xmirakulix/IoTaWatt/Hardware/greg_xmix/PCB.png

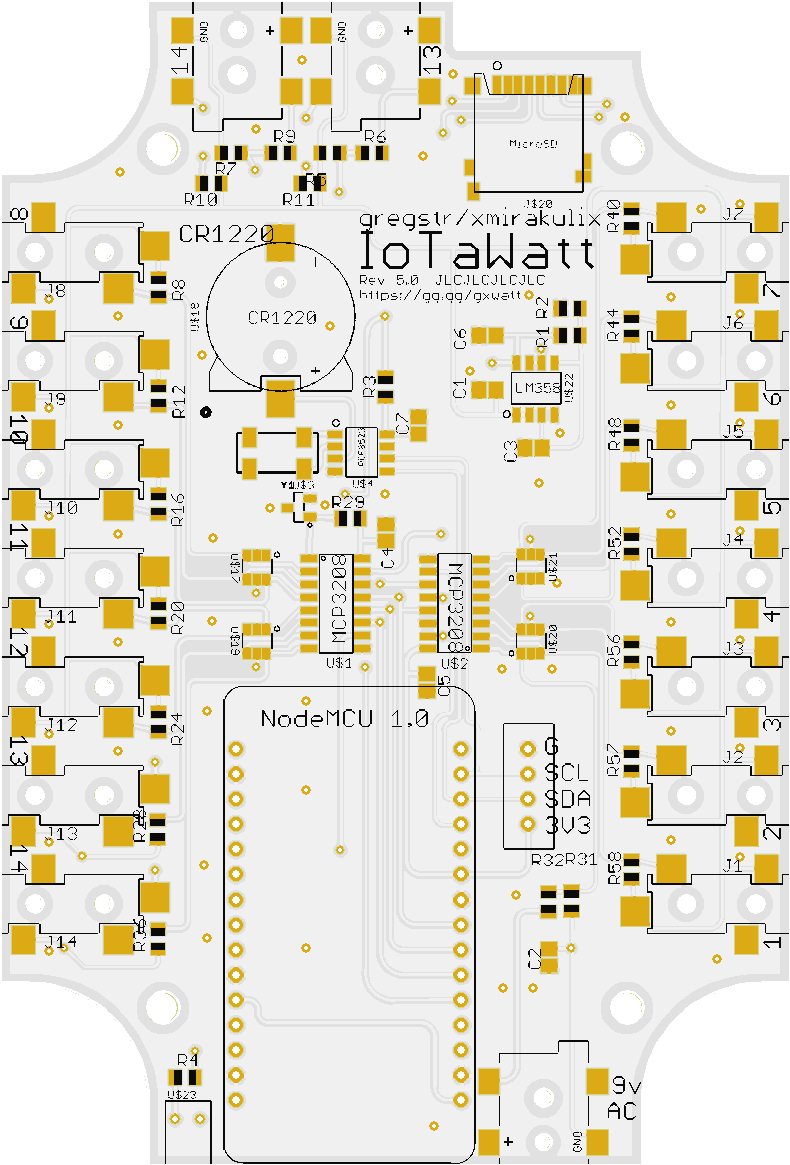
Hardware/greg_xmix/PCB.png
