xmirakulix/IoTaWatt/Hardware/greg_xmix/Parts List.xlsx

Part | Name | Footprint | Anzahl | LCSC Part | LCSC Preis | DigiKey Part | DigiKey Preis | Link | Amazon Preis
.1uF | C3 C4 C5 C6 | C0805 | 4 | C49678 | $0.0043
10uF | C1 C2 C7 | C0805 | 3 | C15850 | $0.0132
None | R10 R11 | R0805 | 2 | C17477 | $0.0022
20 | R8 R12 R16 R20 R24 R28 R36 R40 R44 R48 R52 R56 R57 R58 | R0805 | 14 | C723660 | $0.0470
220 | R4 | R0805 | 1 | C17557 | $0.0018
1K | R3 R5 R7 R29 R31 | R0805 | 5 | C309081 | $0.0286
4.7K | R1 R2 | R0805 | 2 | C515732 | $0.0319
12K | R6 R9 R32 | R0805 | 3 | C515719 | $0.0367
32Khz | Y1 | CRYSTAL_8X3.8 | 1 | C179637 | $1.5436
LM358_DUAL_OP-AMP | U$22 | SOIC_8 | 1 | C5423 | $0.1311
MCP3208 | U$1 U$2 | SOIC_16 | 2 | C16939 | $4.6200
PCF8523_RTC | U$4 | SOIC_8 | 1 | C2651516 | $1.6402
TVS_4CHAN_ARRAYSC-74 | U$17 U$19 U$20 U$21 | SC-74 | 4 | C531179 | $0.2134
STEREO_SMD | J1 J2 J3 J4 J5 J6 J7 J8 J9 J10 J11 J12 J13 J14 | STEREO_SMT | 14 |  |  | CP-3524SJCT-ND | €0.7704
MICROSD_PUSH/PULL | J$20 | MICROSD | 1 |  |  | 114-00841-68-1-ND | €1.3900
2.1MMJACKSMT | J0 J15 J16 | DCJACK_2MM_SMT | 3 |  |  | CP-002AHPJCT-ND | €1.3800
VREF_SHUNT | U$3 | SOT23_3 | 1 |  |  | LM4040BIM3-2.5CT-ND | €1.8600
CR1220SMD | U$18 | CR1220SMD | 1 |  |  | BC501SM-ND | €1.0500
HEADER_1X4 | U$5 | HEADER_1X4 | 1 |  |  | 2057-PH1-04-UA-ND | €0.0900
LED_RT_TRH | U$23 | LED_TH_RT | 1 |  |  | 67-2237-ND | €0.9500
NODEMCU | U$16 | NODEMCU | 1 |  |  |  |  | https://www.amazon.de/dp/B0754LZ73Z | €4.3000
SD Card |  |  | 1 |  |  |  |  | https://www.amazon.de/Verbatim-44082-Klasse-Micro-Adapter/dp/B00CBAUIEU/ | €5.5300
 |  |  |  | Summe | $14.45 |  | €20.2656 |  | €9.8300
 |  |  |  | x5 | $111.00 |  | €101.3280 |  | €49.1500
 |  |  |  |  | 55 EUR pro Stk
