xmirakulix/IoTaWatt/Hardware/greg_xmix/Eagle/IotaWatt5.0.brd

## EAGLE design Hardware/greg_xmix/Eagle/IotaWatt5.0.brd (2023-01-08)

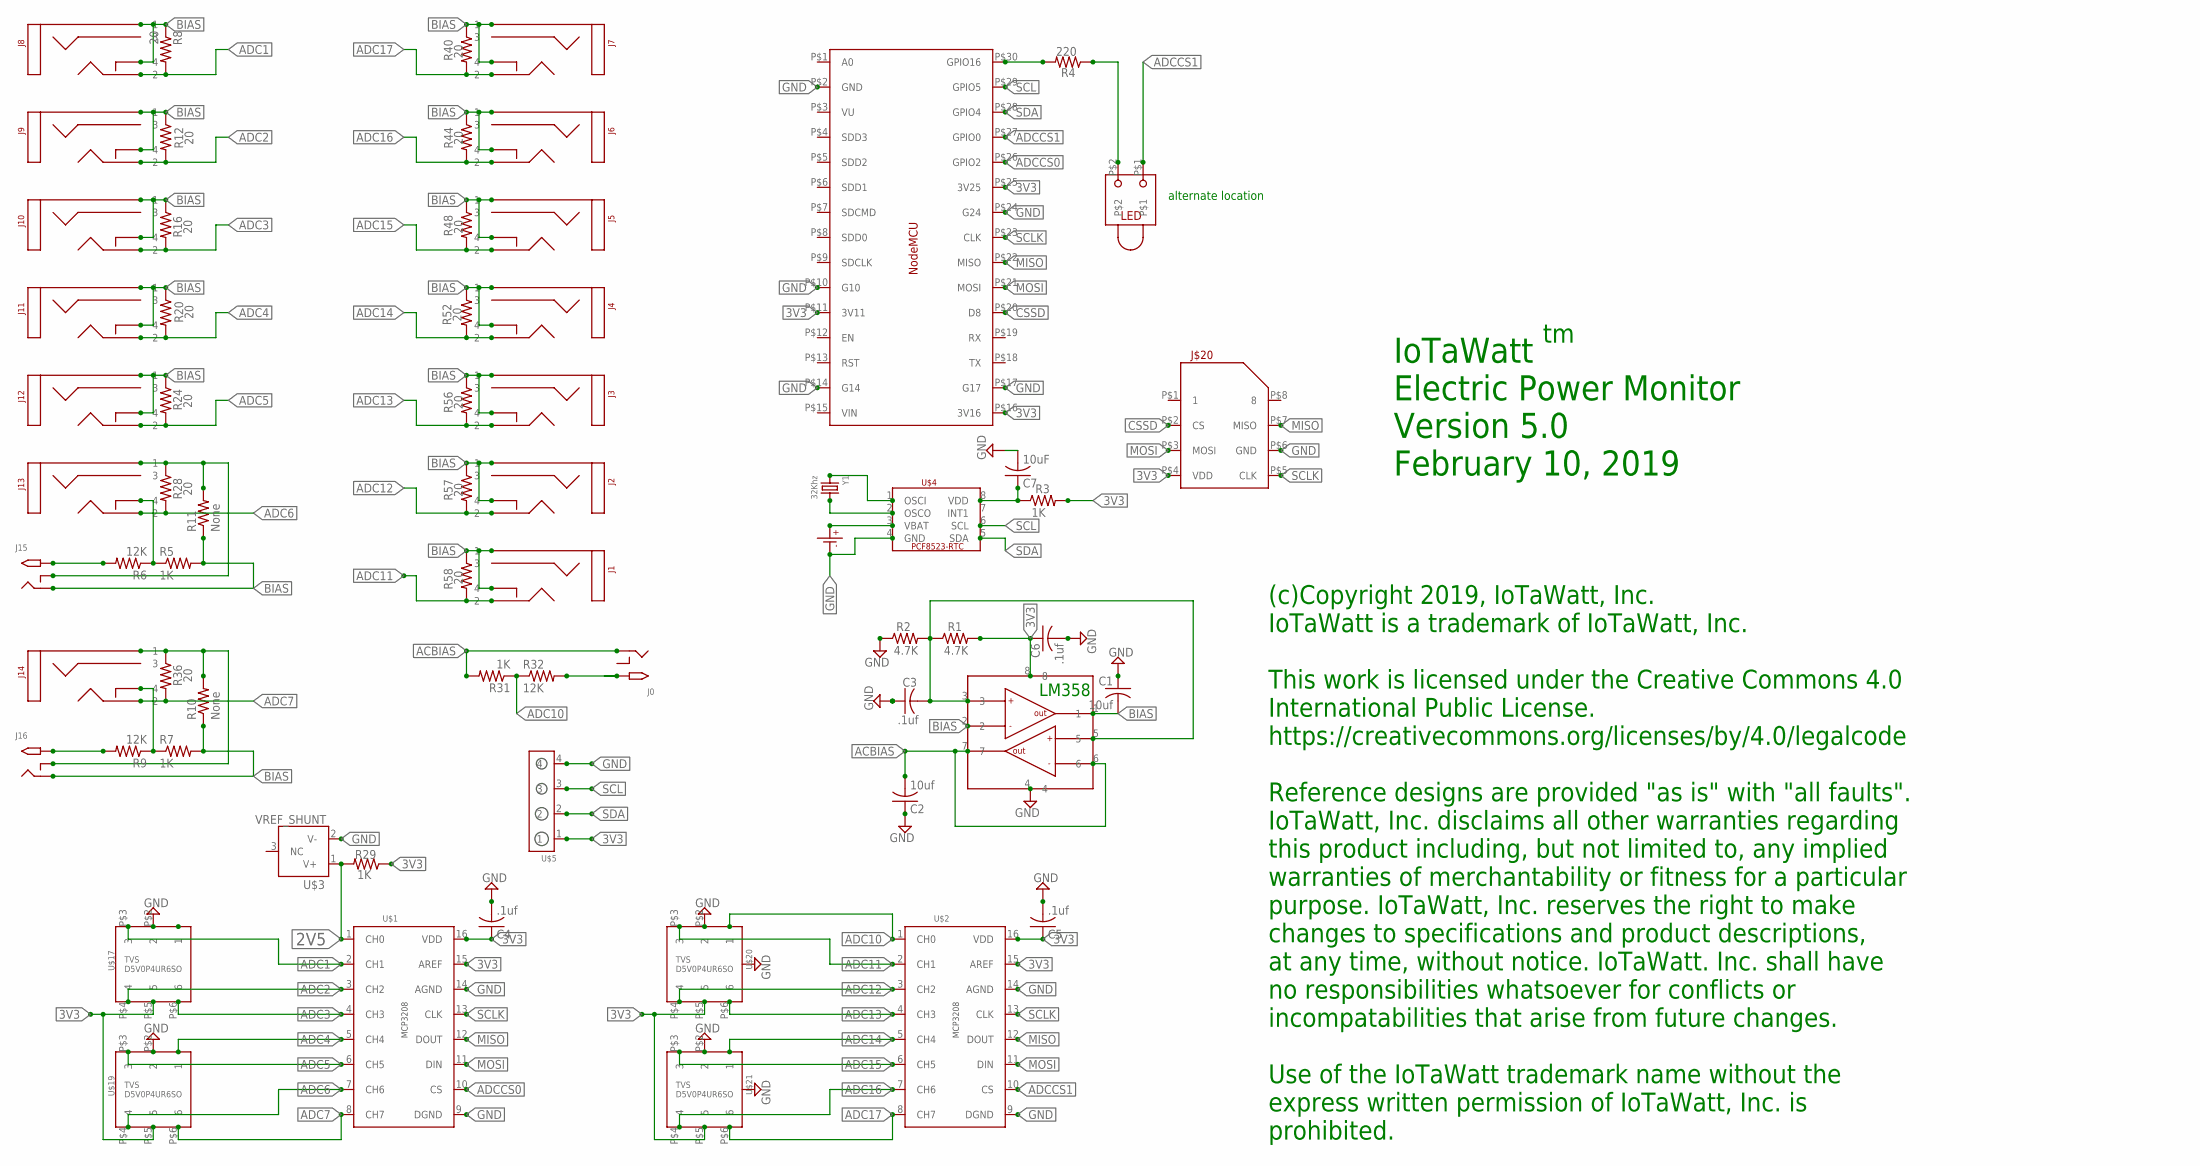
[picture p2: schematic IotaWatt5.0.sch]

Parts:
C1, C2: 10uf; C0805; LCSC_PART C15850
C3, C4, C5, C6: .1uf; C0805; LCSC_PART C49678
C7: 10uF; C0805; LCSC_PART C15850
J0, J15, J16: 2.1MMJACKSMT; DCJACK_2MM_SMT
J1, J2, J3, J4, J5, J6, J7, J8, J9, J10, J11, J12, J13, J14: STEREO_SMD; STEREO_SMT
J$20: MICROSD_PUSH/PULL; MICROSD
R1, R2: 4.7K; R0805; LCSC_PART C515732
R3, R5, R7, R29, R31: 1K; R0805; LCSC_PART C309081
R4: 220; R0805; LCSC_PART C17557
R6, R9, R32: 12K; R0805; LCSC_PART C515719
R8, R12, R16, R20, R24, R28, R36, R40, R44, R48, R52, R56, R57, R58: 20; R0805; LCSC_PART C723660
R10, R11: None; R0805; LCSC_PART C17477
U$1, U$2: MCP3208; SOIC_16; LCSC_PART C16939
U$3: VREF_SHUNT; SOT23_3
U$4: PCF8523_RTC; SOIC_8; LCSC_PART C2651516
U$5: HEADER_1X4
U$16: NODEMCU
U$17, U$19, U$20, U$21: TVS_4CHAN_ARRAYSC-74; SC-74; LCSC_PART C531179
U$18: CR1220SMD
U$22: LM358_DUAL_OP-AMP; SOIC_8; LCSC_PART C5423
U$23: LED_RT_TRH; LED_TH_RT
Y1: 32Khz; CRYSTAL_8X3.8; LCSC_PART C179637

Connections:
2V5: R29.2, U$1.1 (CH0), U$3.1 (V+)
3V3: C4.1, C5.1, C6.1, J$20.P$4 (VDD), R1.2, R3.2, R29.1, U$1.15 (AREF), U$1.16 (VDD), U$2.15 (AREF), U$2.16 (VDD), U$5.1, U$16.P$11 (3V11), U$16.P$16 (3V16), U$16.P$25 (3V25), U$17.P$5 (5), U$19.P$5 (5), U$20.P$5 (5), U$21.P$5 (5), U$22.8
ACBIAS: C2.2, J0.GND (RING), R31.2, U$22.6, U$22.7
ADC1: J8.P$2 (2), R8.2, U$1.2 (CH1), U$17.P$3 (3)
ADC2: J9.P$2 (2), R12.2, U$1.3 (CH2), U$17.P$4 (4)
ADC3: J10.P$2 (2), R16.2, U$1.4 (CH3), U$17.P$6 (6)
ADC4: J11.P$2 (2), R20.2, U$1.5 (CH4), U$19.P$1 (1)
ADC5: J12.P$2 (2), R24.2, U$1.6 (CH5), U$19.P$3 (3)
ADC6: J13.P$2 (2), R28.2, U$1.7 (CH6), U$19.P$4 (4)
ADC7: J14.P$2 (2), R36.2, U$1.8 (CH7), U$19.P$6 (6)
ADC10: R31.1, R32.1, U$2.1 (CH0), U$20.P$1 (1)
ADC11: J1.P$2 (2), R58.2, U$2.2 (CH1), U$20.P$3 (3)
ADC12: J2.P$2 (2), R57.2, U$2.3 (CH2), U$20.P$4 (4)
ADC13: J3.P$2 (2), R56.2, U$2.4 (CH3), U$20.P$6 (6)
ADC14: J4.P$2 (2), R52.2, U$2.5 (CH4), U$21.P$1 (1)
ADC15: J5.P$2 (2), R48.2, U$2.6 (CH5), U$21.P$3 (3)
ADC16: J6.P$2 (2), R44.2, U$2.7 (CH6), U$21.P$4 (4)
ADC17: J7.P$2 (2), R40.2, U$2.8 (CH7), U$21.P$6 (6)
ADCCS0: U$1.10 (CS), U$16.P$26 (GPIO2)
ADCCS1: U$2.10 (CS), U$16.P$27 (GPIO0), U$23.P$1
BIAS: C1.2, J1.P$1 (1), J1.P$4 (4), J2.P$1 (1), J2.P$4 (4), J3.P$1 (1), J3.P$4 (4), J4.P$1 (1), J4.P$4 (4), J5.P$1 (1), J5.P$4 (4), J6.P$1 (1), J6.P$4 (4), J7.P$1 (1), J7.P$4 (4), J8.P$1 (1), J8.P$4 (4), J9.P$1 (1), J9.P$4 (4), J10.P$1 (1), J10.P$4 (4), J11.P$1 (1), J11.P$4 (4), J12.P$1 (1), J12.P$4 (4), J15.GND (RING), J16.GND (RING), R5.2, R7.2, R8.1, R10.1, R11.1, R12.1, R16.1, R20.1, R24.1, R40.1, R44.1, R48.1, R52.1, R56.1, R57.1, R58.1, U$22.1, U$22.2
CSSD: J$20.P$2 (CS), U$16.P$20 (D8)
GND: C1.1, C2.1, C3.1, C4.2, C5.2, C6.2, C7.2, J$20.P$6 (GND), R2.1, U$1.9 (DGND), U$1.14 (AGND), U$2.9 (DGND), U$2.14 (AGND), U$3.2 (V-), U$4.4 (GND), U$5.4, U$16.P$2 (GND), U$16.P$10 (G10), U$16.P$14 (G14), U$16.P$17 (G17), U$16.P$24 (G24), U$17.P$2 (2), U$18.P- (P$-), U$19.P$2 (2), U$20.P$2 (2), U$21.P$2 (2), U$22.4
MISO: J$20.P$7 (MISO), U$1.12 (DOUT), U$2.12 (DOUT), U$16.P$22 (MISO)
MOSI: J$20.P$3 (MOSI), U$1.11 (DIN), U$2.11 (DIN), U$16.P$21 (MOSI)
unnamed: C7.1, R3.1, U$4.8 (VDD)
unnamed: J15.PWR2 (TIP), R6.2
unnamed: J16.PWR2 (TIP), R9.2
unnamed: J14.P$1 (1), J16.GNDBREAK (RING_SW), R10.2, R36.1
unnamed: J13.P$1 (1), J15.GNDBREAK (RING_SW), R11.2, R28.1
unnamed: J14.P$4 (4), R7.1, R9.1
unnamed: R4.1, U$23.P$2
unnamed: J13.P$4 (4), R5.1, R6.1
unnamed: R4.2, U$16.P$30 (GPIO16)
unnamed: J0.PWR2 (TIP), R32.2
unnamed: U$4.3 (VBAT), U$18.P+ (P$+)
unnamed: U$4.2 (OSCO), Y1.P$4 (2)
unnamed: U$4.1 (OSCI), Y1.P$1 (1)
SCL: U$4.6 (SCL), U$5.3, U$16.P$29 (GPIO5)
SCLK: J$20.P$5 (CLK), U$1.13 (CLK), U$2.13 (CLK), U$16.P$23 (CLK)
SDA: U$4.5 (SDA), U$5.2, U$16.P$28 (GPIO4)
VREF: C3.2, R1.1, R2.2, U$22.3, U$22.5

Notes on the sheet:
IoTaWatt Electric Power Monitor Version 5.0 February 10, 2019
alternate location
LM358
(c)Copyright 2019, IoTaWatt, Inc. IoTaWatt is a trademark of IoTaWatt, Inc. This work is licensed under the Creative Commons 4.0 International Public License. https://creativecommons.org/licenses/by/4.0/legalcode Reference designs are provided "as is" with "all faults". IoTaWatt, Inc. disclaims all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

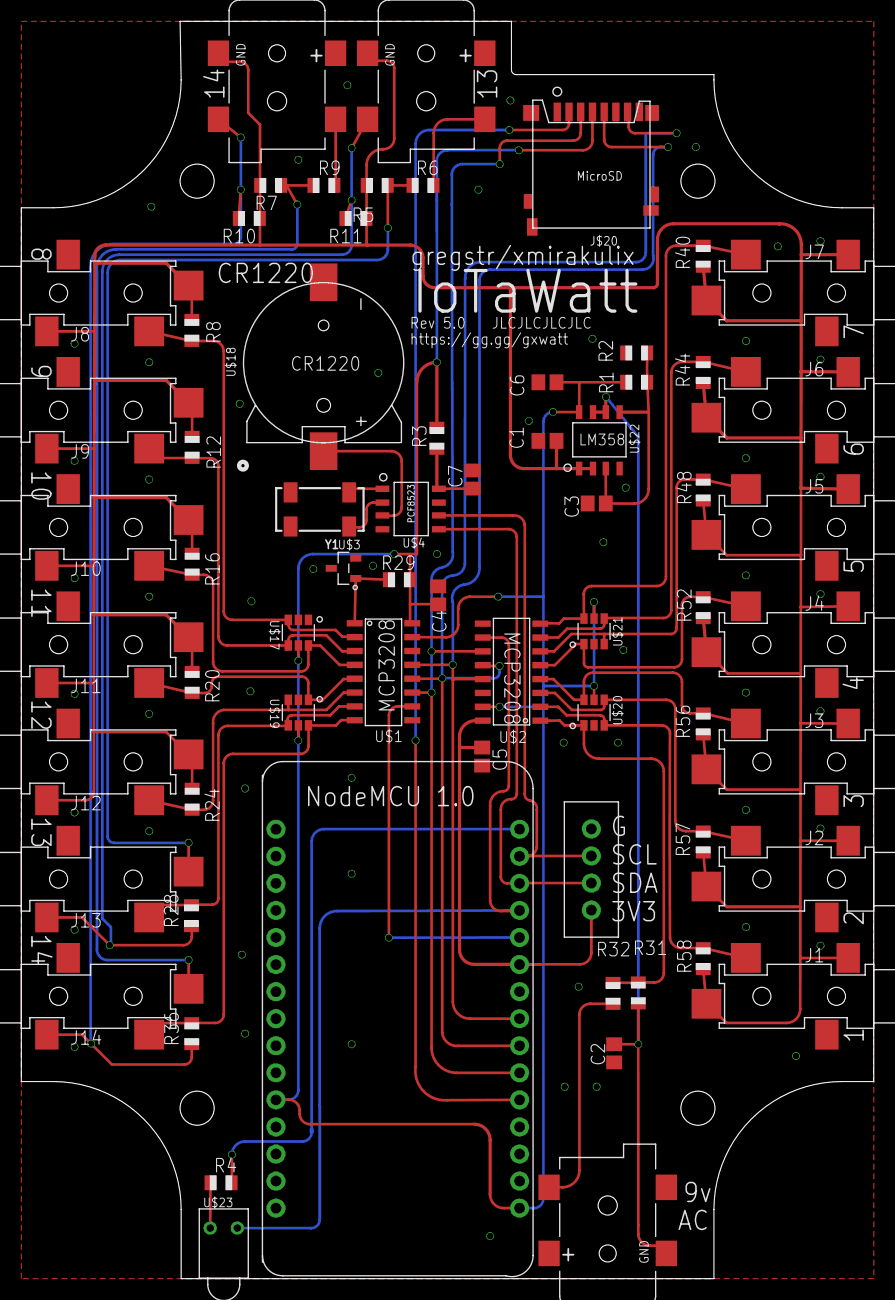
[picture p3: board IotaWatt5.0.brd from above]

Board: 2 copper layers, 80.0 x 118.0 mm, 66 parts (0 on the bottom side), 42 nets.
