xmirakulix/IoTaWatt/(commit log)

2023-01-07 Eagle project created
    [IotaWatt5.0.brd, IotaWatt5.0.sch]
2023-01-07 added LCSC part numbers
    [IotaWatt5.0.brd, IotaWatt5.0.sch]
2023-01-07 production files generated
    [IotaWatt5.0_bom.csv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]
2023-01-07 part list added
    [Parts List.xlsx]
2023-01-08 corrected silkscreen
    [IotaWatt5.0.brd, IotaWatt5.0.sch]
2023-01-08 silkscreen upated
    [IotaWatt5.0.brd]
2023-01-08 url added
    [IotaWatt5.0.brd]
2023-01-08 JLC design rules
    [IotaWatt5.0.brd]
2023-01-08 part list updated
    [Parts List.xlsx]
2023-01-21 PCB added
